whoim2/esp-ir-center-and-relays/android/photo_2022-09-16_19-06-49.jpg

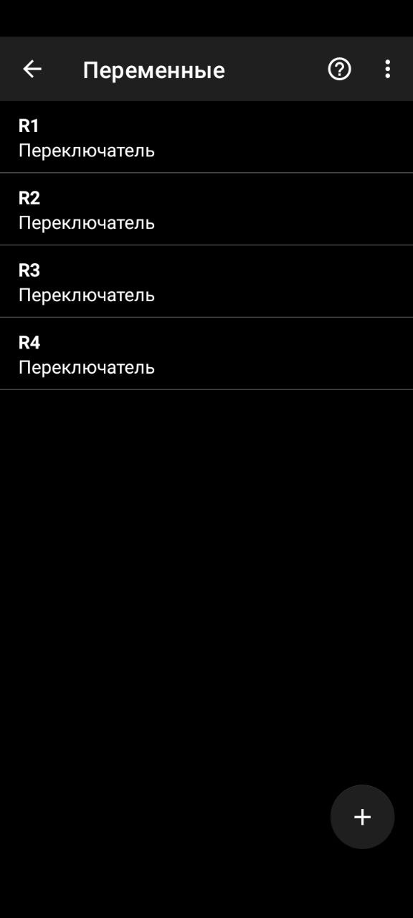
android/photo_2022-09-16_19-06-49.jpg
