whoim2/esp-ir-center-and-relays/Screenshot_1.png

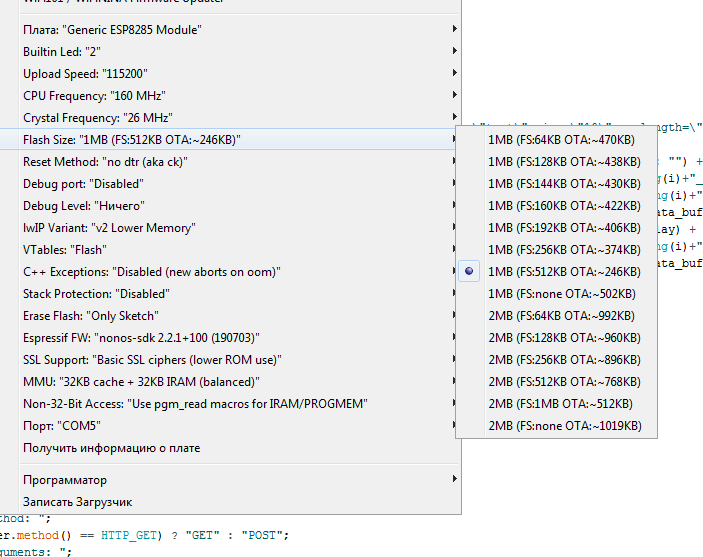
Screenshot_1.png
