whoim2/esp-ir-center-and-relays/(list of files, drawings)

Other design files:
ir_m3.dch
ir_m3.dip
